amr98khaled/8Bit_CPU/Datasheets/Capacitors.JPG

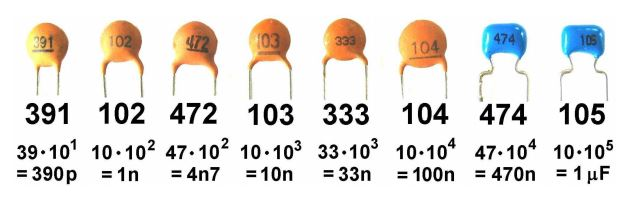
Datasheets/Capacitors.JPG
