amr98khaled/8Bit_CPU/README.md

# 8Bit_CPU
My Project for the 8-Bit Computer inspired by Ben Eater .

Link for my Project : https://youtu.be/mxYdQJgP8KM
